ulitkamosh/Avr/README.md

# Синтезатор звуковых сигналов на базе микроконтроллера ATmega8515

Проект писался в AVRstudio на C. Отладка проекта и его презентация проводилась в среде Proteus.

Устройство представляет собой синтезатор звуковых сигналов, который работает в двух режимах:
- Воспроизведение звуковых сигналов нажатием на кнопки (игра на синтезаторе);
- Воспроизведение мелодий, записанных в памяти МК.

### Структура

- [Более подробное описание проекта;](https://github.com/ulitkamosh/Avr/blob/main/%D0%94%D0%BE%D0%BA%D1%83%D0%BC%D0%B5%D0%BD%D1%82%D0%B0%D1%86%D0%B8%D1%8F/RPZ_zhidkov.pdf)
- [Функциональная схема;](https://github.com/ulitkamosh/Avr/blob/main/%D0%94%D0%BE%D0%BA%D1%83%D0%BC%D0%B5%D0%BD%D1%82%D0%B0%D1%86%D0%B8%D1%8F/Funktsionalnaya_skhema_ZHIDKOV.JPG)
- [Принципиальная схема;](https://github.com/ulitkamosh/Avr/blob/main/%D0%94%D0%BE%D0%BA%D1%83%D0%BC%D0%B5%D0%BD%D1%82%D0%B0%D1%86%D0%B8%D1%8F/printsip_skhema_ZHIDKOV.JPG)
- [Код програмы;](https://github.com/ulitkamosh/Avr/tree/main/uarts/uarts)
- [Файл проекта в среде Proteus;](https://github.com/ulitkamosh/Avr/blob/main/uarts/tinyrabotaetuarts1.pdsprj)
- [Скомпилированный HEX файл, загружаемый в МК.](https://github.com/ulitkamosh/Avr/blob/main/uarts/uarts/Debug/uarts.hex)
