ulitkamosh/Avr/Документация/Prilozhenie_B.pdf

# Приложение Б

Спецификация радиоэлементов схемы
