ulitkamosh/Avr/Документация/Spetsifikatsia.pdf

Инв. № подл. Подп. и дата Взам. инв. №

Инв. №

дубл. Подп. и дата Справ. №

Перв. применен.

Изм | Лист | № докум.
Разраб.
Пров.
Т.контр.

Подп. Дата

Н.контр.
Утв.

Хартов В.Я.

Лит. | Масса | Масштаб
Лист | Листов
МГТУ им. Н.Э.Баумана
Кафедра ИУ6
Группа ИУ6-72

Спецификация радиоэлементов схемы

Копировал | Формат

Синтезатор звуковых сигналов

Жидков А.А.

Курсовая работа по дисциплине Микропроцессорные системы

З

о

на

Поз.
обозначе-ние
Наименование | Кол. | Примечание

Резисторы

Микросхемы

Конденсаторы

Прочие элементы

R3 | CF-100 (С1-4) 1 Вт, 10 кОм, 5%, Резистор углеродистый | 1

Микроконтроллер ATmega8515 1

C5
2

1

Q1 | Кварцевый резонатор HC-51/U (1 МГц) | 1
X3 | Разъем питания MPW-2R | 1
| Разъем BH-06 (IDC-06MS) (DS1013-06S)
X1 | | 1
X2 | | 1
R1 | 1

Драйвер MAX232А

C1-C3,С6,

13

CF-100 (С1-4) 1 Вт, 2 кОм, 5%, Резистор углеродистый

DD1
DD2

1

B1 | Кнопка PBS-10B-2 ECAP (К50-35 мини), 0.1мкФ
C4 | ECAP (К50-35 мини), 0.33мкФ
ECAP (К50-35 мини), 47мкФ | 1
ECAP (К50-35 мини), 0.22пкФ
DD3 | LM7805 | 1

5

Разъем 350720-4, вилка 9PINB5B-XH-A

R2, R4-R7 | CF-100 (С1-4) 1 Вт, 10 Ом, 5%, Резистор углеродистый | 5
VT1 | Транзистор КТ3102 | 1

С9

C4

С7, С8

D1 | Динамик 3 ГДШ-2-8 | 1
L1-L4 | Светодиоды L-1154GT | 4
