ulitkamosh/Avr/Документация/Funktsionalnaya_skhema_ZHIDKOV.JPG

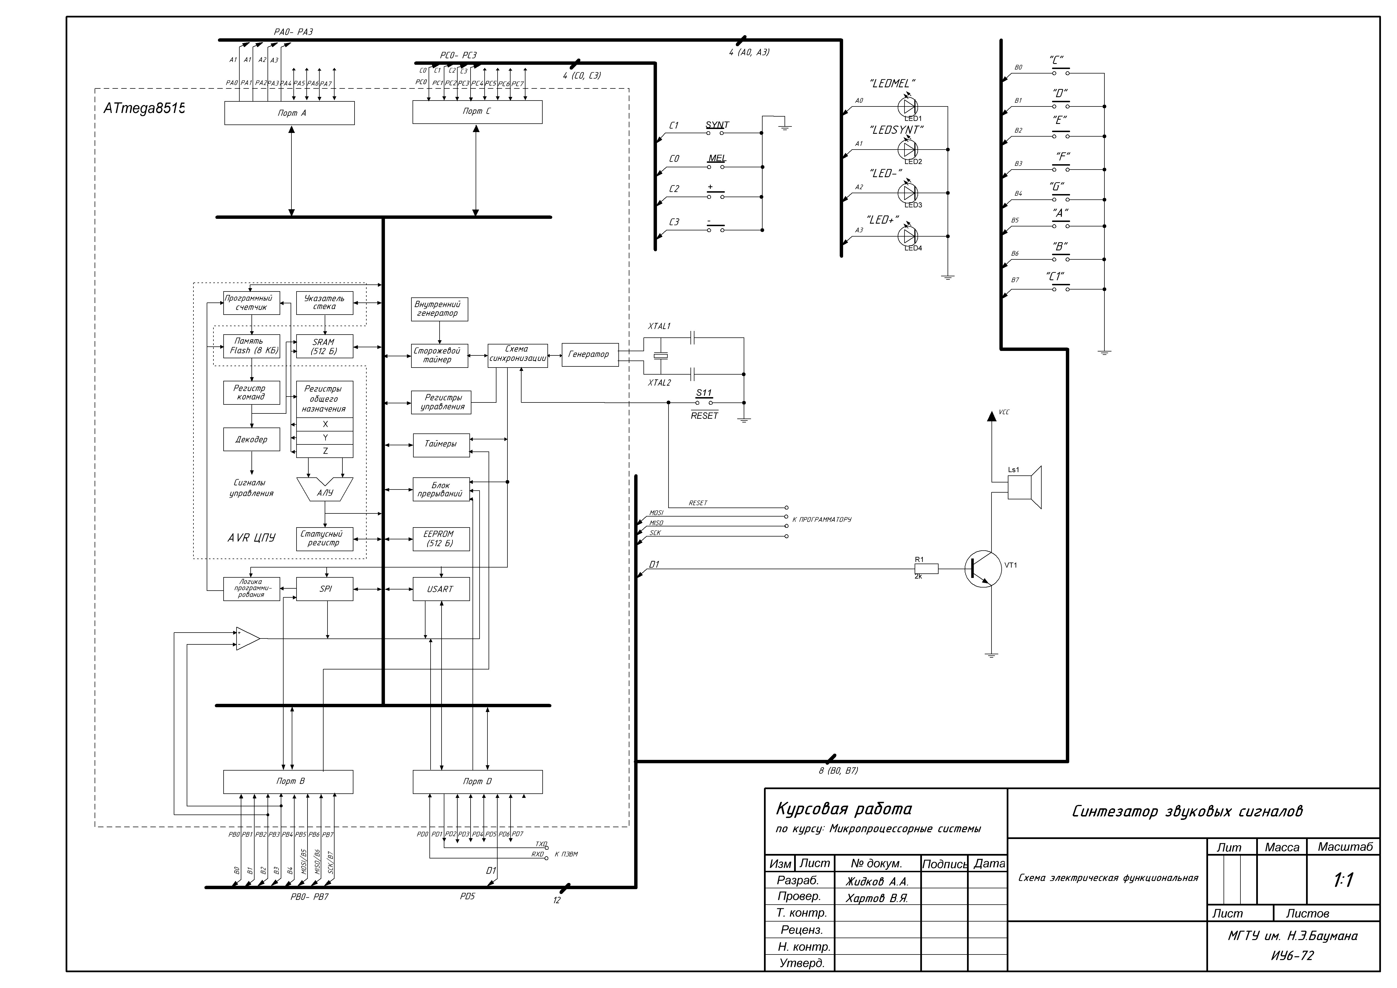
Документация/Funktsionalnaya_skhema_ZHIDKOV.JPG
