ulitkamosh/Avr/Документация/printsip_skhema_ZHIDKOV.JPG

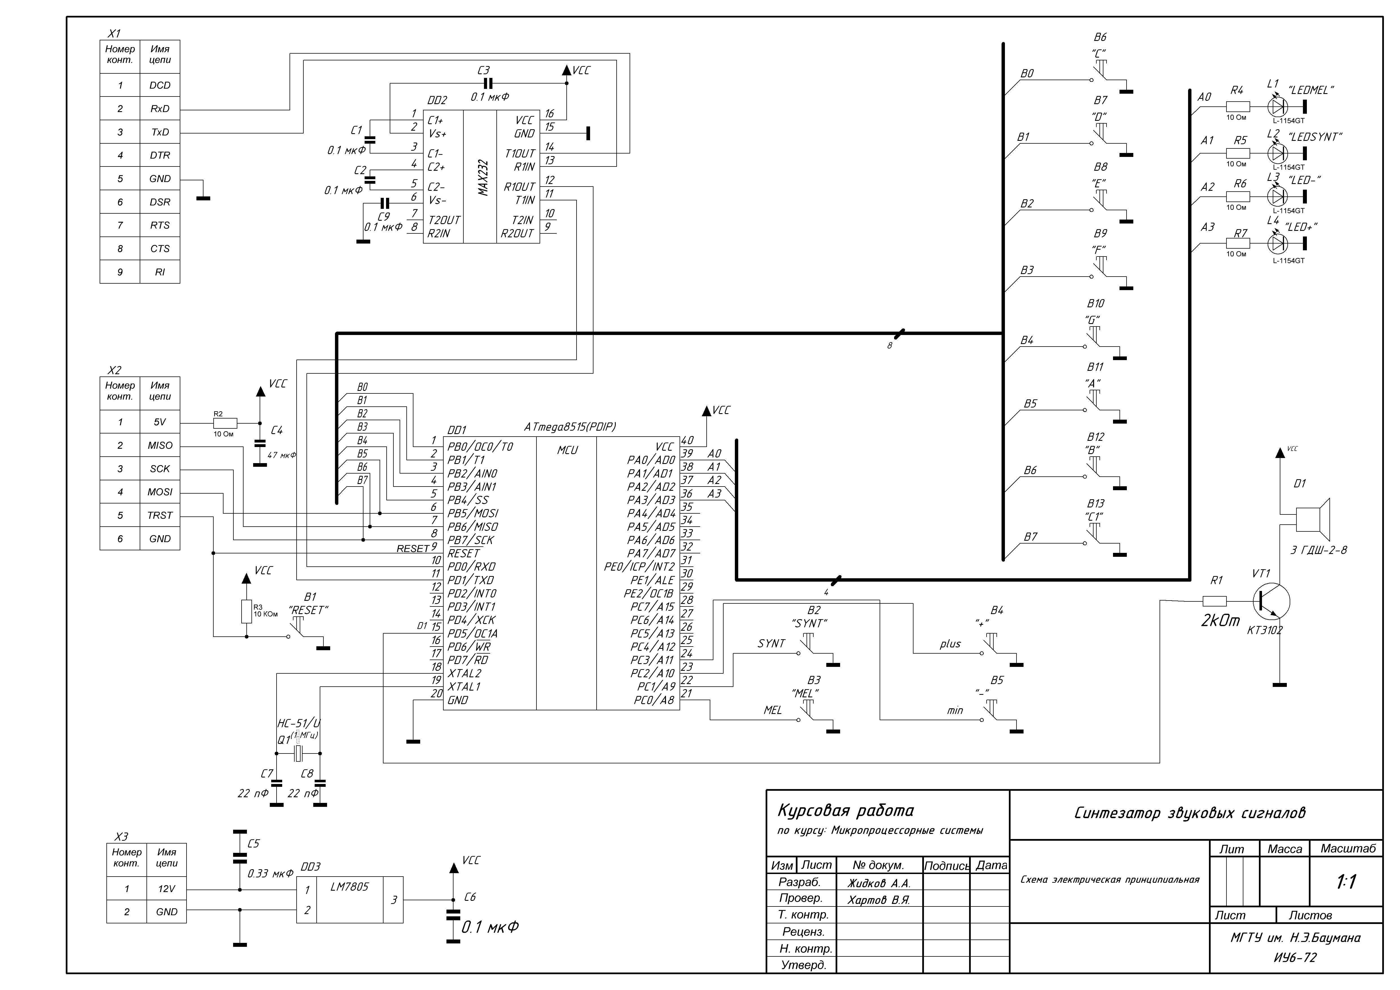
Документация/printsip_skhema_ZHIDKOV.JPG
