ulitkamosh/Avr/(list of files, drawings)

Other design files:
uarts/tinyrabotaetuarts1.pdsprj
